farrukhzaf/spi-asic-configurator/docs/SPI_slave_design_report.pdf

# SPI Slave Register Interface

# Design Report

## From Initial Code Review to ASIC-Ready RTL

### Protocol: SPI Mode 0 (CPOL=0, CPHA=0) Frame: {R/W, A[6:0], D[7:0]} — 16 bits Registers: 5 × 8-bit programmable registers Target FPGA: Xilinx Basys 3 (Artix-7 XC7A35T) Target ASIC: Generic standard-cell library MCU: STM32G474 (SPI Master)

### March 28, 2026

SPI Slave Design Report | 1

## Contents

1 Introduction | 2
2 Design Specification | 2
3 Initial Code Review | 3
4 Revision 1: Functional Verification | 4
5 FPGA Prototyping on Basys 3 | 4
6 Difficulty 1: FPGA Race Condition on Memory Write | 5
7 Difficulty 2: ASIC Design Rule Violations | 6
8 Register Output Ports for Layout Integration | 7
9 Firmware Test Harness (STM32G474) | 8
10 Final Architecture Summary | 9
11 Design Revision History | 10
12 Conclusion | 10

## 1 Introduction

This report documents the complete design journey of an SPI slave register interface, from an initial buggy implementation through iterative debugging, FPGA validation, and final hardening for ASIC tape-out. The design went through five major revisions, each addressing a distinct class of issues discovered through simulation, hardware testing, or design-rule analysis.
The SPI slave provides a simple register-programming interface for an ASIC. An external SPI master (STM32G474 microcontroller) writes configuration data into five 8-bit registers, whose outputs are directly wired to downstream ASIC logic. The interface operates without a system clock—all sequential logic is clocked by the SPI clock (sclk) provided by the master.

## 2 Design Specification

### 2.1 Protocol Definition

Each SPI transaction consists of exactly 16 bits, clocked in SPI Mode 0 (CPOL=0, CPHA=0). The master holds chip select (cs) low for the duration of the 16-bit frame.

Table 1: 16-bit SPI frame format

Bit 15 | Bits [14:8] | Bits [7:0]
R/W | Address (A[6:0]) Data (D[7:0])
- R/W = 1: Write operation. The master sends data on MOSI during clocks 9–16, which is written to the addressed register.
- R/W = 0: Read operation. The slave drives the addressed register’s contents on MISO during clocks 9–16.
Both read and write complete in a single 16-bit transaction.

### 2.2 Register Map

Table 2: SPI register address map

Address | Register | Reset Value
0x00 | reg0 out | 0x00
0x01 | reg1 out | 0x00
0x02 | reg2 out | 0x00
0x03 | reg3 out | 0x00
0x04 | reg4 out | 0x00
0x05--0x7F | Reserved | Read returns 0xFF

### 2.3 SPI Mode 0 Timing

- sclk idles low between transactions.

- The master drives MOSI before the rising edge of sclk.
- The slave samples MOSI on the rising edge of sclk.
- The slave drives MISO on the falling edge of sclk, giving a full half-cycle of setup time before the master samples on the next rising edge.

## 3 Initial Code Review

The starting point was a Verilog module with five critical bugs. This section documents each issue and the rationale for the fix.

### 3.1 Bug 1: Inverted R/W Polarity

The specification defined the first bit as R/W bar: 1 = Read, 0 = Write. However, the original code treated rw bit == 1 as a write operation, reversing the intended behavior.

### 3.2 Bug 2: MISO Driven During the Wrong Phase

The original code used a condition miso cnt < 8 to drive MISO, which output data during the address phase (clocks 1–8). For a read operation, the slave must drive data during the data phase (clocks 9–16).

### 3.3 Bug 3: Late tx buffer Load

The tx buffer was loaded on posedge cs (the end of the transaction). For a sametransaction read, the data must be available before clock 9. The original design was effectively one full transaction late.
Solution — Predictive Load: At bit count == 7 on posedge sclk, the address is reconstructed from the current shift reg[5:0] (providing addr[6:1]) and the live mosi wire (providing addr[0]). This loads tx buffer at posedge 8, making it available by negedge 8 when MISO output begins.
1 | always @ ( posedge sclk or negedge rst_n ) begin
2 | if (! rst_n )
3 | tx_buffer <= 8 ’ h00 ;
4 | else if (! cs && bit_count == 5 ’ d7 && ! shift_reg [6]) begin
5 | if ({ shift_reg [5:0] , mosi } < MEM_DEPTH )
6 | tx_buffer <= reg_file [{ shift_reg [5:0] , mosi }];
7 | else
8 | tx_buffer <= 8 ’ hFF ;
9 | end
10 | end

Listing 1: Predictive tx buffer load

### 3.4 Bug 4: Combinational MISO Glitches

The original design used always @(*) to drive MISO, creating a combinational output path prone to glitches between clock edges. In Mode 0, MISO must be registered on negedge sclk to ensure stability when the master samples on the next rising edge.

### 3.5 Bug 5: Redundant Counters

Two separate counters (bit count and miso cnt) tracked the same transaction progress on different clock edges. A single bit count on posedge sclk suffices for both shift-in and shift-out logic.

## 4 Revision 1: Functional Verification

After fixing the five bugs identified in Section 3, a comprehensive testbench was written with seven test categories:

Table 3: Testbench coverage matrix

Test Category | Description
1 | Write all | Write distinct patterns to all 5 registers
2 | Read back | Read each register via MISO and compare
3 | Overwrite | Overwrite one register, verify others un-
touched
4 | Out-of-range RD | Read from invalid addresses (expect 0xFF)
5 | Out-of-range WR Write to invalid address, verify no corrup-
tion
6 | Zero value | Write and read 0x00 (distinguishable)
7 | Async reset | Assert rst n, verify all registers cleared

All 14 checks passed in Icarus Verilog simulation.

## 5 FPGA Prototyping on Basys 3

### 5.1 Top-Level Wrapper

A minimal top-level module mapped the SPI signals to PMOD JA pins on the Digilent Basys 3 board. The center push-button (BTNC) was used as an active-high reset, inverted internally to provide rst n.

Table 4: PMOD JA pin assignment

PMOD Pin Package Pin Signal | Direction
JA1 | J1 | sclk | Input
JA2 | L2 | mosi | Input
JA3 | J2 | cs | Input
JA4 | G2 | miso | Output
— | U18 | btnC | Input (reset)

### 5.2 XDC Constraints

A create clock constraint was applied to the SCLK input on PMOD JA with a 100 ns period (10 MHz). Configuration voltage was set to 3.3 V LVCMOS to match the PMOD

standard.

## 6 Difficulty 1: FPGA Race Condition on Memory Write

### 6.1 Symptom

The STM32 firmware test harness reported that all read-back values were incorrect after writing to multiple registers in sequence. Single-register write-then-read worked sporadically.

Table 5: Failing UART output (excerpt)

Test | Result

addr 0x00 got 0x00, expected 0xA5 — FAIL addr 0x02 got 0x0C, expected 0x0F — FAIL addr 0x03 got 0x01, expected 0x81 — FAIL

### 6.2 Root Cause Analysis

The memory write block triggered on posedge cs and sampled bit count == 16. However, the bit counter block also triggered on posedge cs, asynchronously resetting bit count to zero.
In simulation, Verilog’s non-blocking assignment semantics guarantee that both blocks see the old value of bit count at the same posedge cs. On real FPGA hardware, the asynchronous reset path through the clear pin of the bit count flip-flops is faster than the clocked data path to the memory-write logic. By the time the memory-write block’s flip-flops evaluate bit count, it has already been forced to zero.
This is a classic simulation-versus-hardware mismatch caused by racing asynchronous reset paths.

### 6.3 Fix: Move Memory Write to posedge sclk

The memory write was moved to fire on the 16th rising edge of sclk (detected as bit count == 15 pre-NBA). At this point, the frame is reconstructed from shift reg[14:0] and the live mosi wire:

1 | always @ ( posedge sclk or negedge rst_n ) begin
2 | if (! rst_n ) begin
3 | for ( i = 0; i < MEM_DEPTH ; i = i + 1)
4 | reg_file [ i ] <= 8 ’ h00 ;
5 | end else if (! cs && bit_count == 5 ’ d15 ) begin
6 | if ( shift_reg [14] && shift_reg [13:7] < MEM_DEPTH )
7 | reg_file [ shift_reg [13:7]] <= { shift_reg [6:0] , mosi };
8 | end
9 | end

Listing 2: Race-free memory write on posedge sclk

This completely eliminated the dependency on posedge cs for writes, removing the race condition. After this fix, all 17 firmware tests passed on hardware.

## 7 Difficulty 2: ASIC Design Rule Violations

While the FPGA-proven design was functionally correct, it contained several patterns that would cause failures during ASIC synthesis, STA, DFT, and physical design.

### 7.1 Issue 1: cs Used as Asynchronous Reset

In the FPGA version, posedge cs appeared in sensitivity lists for the bit counter, shift register, and MISO output. ASIC synthesis tools would route cs through a reset tree, but since cs transitions asynchronously relative to sclk, recovery and removal timing checks would fail. There is no deterministic timing relationship for STA tools to close on.

### 7.2 Issue 2: Multiple Clock Edges

posedge sclk and negedge sclk constitute two separate clock domains in ASIC timing analysis. Every signal crossing between them would be flagged as a clock-domain crossing (CDC) violation. Clock-tree synthesis (CTS) would need to build two independent clock trees from the same pin.

### 7.3 Issue 3: Scan Testability

DFT insertion requires controllable clocks and resets. With cs simultaneously acting as both a data input and an asynchronous reset, scan chains cannot properly shift through the affected flip-flops. The design would fail DFT rule checks.

### 7.4 Issue 4: Glitch Sensitivity

FPGA routing provides clean, glitch-free signal paths. On ASIC, any runt pulse or coupling-induced glitch on cs would corrupt bit count because it is wired as an asynchronous reset with no filtering.

### 7.5 The “Purely Synchronous” Dead End

The first attempted fix was to make the design fully synchronous: sample cs on posedge sclk using a delayed copy (cs d) for edge detection, and use an active flag to track frame boundaries.
This approach failed fundamentally because in SPI Mode 0, sclk idles low between transactions. With no clock edges between frames, the synchronous logic never observes cs going high and then low again. The bit count remained stuck at 16 from the previous transaction, and all subsequent transactions failed.

### 7.6 The Correct ASIC Solution

The solution applies cs as an asynchronous clear to bit count only—not as a generalpurpose clock or reset for all logic:

1 | always @ ( posedge sclk or posedge cs or negedge rst_n ) begin
2 | if (! rst_n )
3 | bit_count <= 5 ’ b0 ;
4 | else if ( cs )
5 | bit_count <= 5 ’ b0 ;
6 | else if ( bit_count < 5 ’ d16 )
7 | bit_count <= bit_count + 1 ’ b1 ;
8 | end

Listing 3: Targeted async clear on bit count

This is safe because the SPI protocol guarantees that cs transitions only while sclk is idle (low in Mode 0). There is no simultaneous clock edge to race against, so recovery/removal timing is inherently satisfied.
All other blocks sample cs as a synchronous data input via posedge sclk, and only rst n serves as the global asynchronous reset.

Table 6: FPGA vs. ASIC design comparison

Concern | FPGA Version | ASIC Version
cs as clock | posedge cs triggers memory writes Never
Clock domains | 3 (posedge, negedge, posedge cs) | 2 (posedge + 1 negedge flop)
cs as async reset Resets bit count, shift reg, miso | Clears bit count only
DFT / Scan | Not testable | Clean
Memory write | On posedge cs (race) | On posedge sclk

### 7.7 SDC Constraints for ASIC

The following Synopsys Design Constraints are required:

1 | # Primary SPI clock
2 | create_clock -name sclk -period <T > [ get_ports sclk ]

3
4 | # Inverted clock for the single MISO output flop
5 | create_generated_clock -name sclk_inv \
6 | -source [ get_ports sclk ] \
7 | -divide_by 1 -invert \
8 | [ get_pins miso_reg / CK ]

9
10 | # cs-to-bit_count async clear is safe (SPI protocol guarantee )
11 | set_false_path -from [ get_ports cs ] \
12 | -to [ get_pins bit_count_reg* / CLR ]

Listing 4: SDC constraints for the SPI slave

## 8 Register Output Ports for Layout Integration

The final revision replaced the internal memory array with named registers (reg file) and exposed their contents as output ports. This change was necessary for two reasons:

1. Functional: Without output ports, downstream ASIC logic cannot access the register values.
2. Physical design: Synthesis tools may infer the reg [7:0] memory [0:4] array as a small RAM or generate awkwardly named nets (memory reg 0 , etc.) that are difficult to trace in layout and LVS. Named output ports produce clean, predictable pin names in LEF/DEF.
1 | output wire [7:0] reg0_out , | // addr 0x00
2 | output wire [7:0] reg1_out , | // addr 0x01
3 | output wire [7:0] reg2_out , | // addr 0x02
4 | output wire [7:0] reg3_out , | // addr 0x03
5 | output wire [7:0] reg4_out | // addr 0x04

6
7 | // ...
8 | assign reg0_out = reg_file [0];
9 | assign reg1_out = reg_file [1];
10 | assign reg2_out = reg_file [2];
11 | assign reg3_out = reg_file [3];
12 | assign reg4_out = reg_file [4];

Listing 5: Register output port declarations

The outputs are purely combinational (assign from register flip-flops)—zero additional logic. They update on the 16th SCLK rising edge of a write transaction, hold their value indefinitely until the next write or reset, and go to 0x00 on rst n assertion.

## 9 Firmware Test Harness (STM32G474)

An STM32G474 microcontroller served as the SPI master for hardware validation. The firmware test harness on the STM32 mirrored all seven simulation test categories plus hardware-specific checks.

### 9.1 Test Architecture

The firmware used three helper functions:
- asic write(addr, val) — SPI write with error checking.
- asic read(addr, &val) — SPI read with error checking.
- check(addr, expected) — Read-and-compare with [PASS]/[FAIL] logging via UART at 115200 baud.
Hardware reset (Test 7) was implemented using a dedicated GPIO pin driving the ASIC’s rst n input, with 2 ms assert/deassert delays.

### 9.2 Final Hardware Results

Table 7: Final FPGA hardware test results

Test Category | Result
1 | Write all 5 registers | PASS (5/5)
2 | Read back all 5 registers | PASS (5/5)
3 | Overwrite addr 0, verify others | PASS (2/2)
4 | Read out-of-range addresses | PASS (2/2)
5 | Write out-of-range, no corruption | PASS (2/2)
6 | Write and read 0x00 | PASS (1/1)
7 | Hardware reset clears all registers | PASS (5/5)
Total | 17/17 PASSED

## 10 Final Architecture Summary

The final RTL consists of five cleanly separated always blocks:

Table 8: Final RTL block summary

Block Function | Clock Edge | Async | Domain
1 | Bit counter | posedge sclk | rst n, cs | sclk
2 | Shift register | posedge sclk | rst n | sclk
3 | TX buffer load posedge sclk | rst n | sclk
4 | MISO output | negedge sclk | rst n | sclk inv
5 | Memory write | posedge sclk | rst n | sclk

Key properties of the final design:
- Single clock source: All logic derives from sclk. Only the MISO output flop uses the inverted edge, constrained as a generated clock (sclk inv).
- Single global async reset: Only rst n resets all flip-flops.
- Targeted async clear: cs clears only bit count, with protocol-guaranteed safety.
- No combinational outputs: MISO is fully registered.
- No system clock dependency: The entire design operates solely from the SPI master’s clock.
- DFT-ready: One scan-mode mux on the negedge MISO flop.
- Clean output ports: Five named 8-bit outputs for direct connection to downstream ASIC logic.

## 11 Design Revision History

Table 9: Design revision timeline

Rev Milestone | Key Changes
0 | Initial code | Original submission with 5 bugs
1 | Simulation pass | Fixed R/W polarity, MISO timing, pre-
dictive tx buffer, registered MISO, single counter
2 | Signal rename | Changed cs n → cs; | R/W: 1=Write,
| | 0=Read
3 | FPGA race fix | Moved memory write from posedge cs to
| | posedge sclk
4 | ASIC hardening Removed cs as clock/reset except targeted
bit count clear; SDC constraints added
5 | Output ports | Replaced memory array with reg file;
added reg[0..4] out ports

## 12 Conclusion

This design evolved through five revisions, each driven by a specific failure mode. The initial code review caught fundamental protocol bugs visible in simulation. FPGA testing revealed a hardware race condition invisible to simulation. ASIC design-rule analysis exposed structural issues that would have caused synthesis, timing, and DFT failures. The final RTL is simultaneously functional on FPGA (validated with 17/17 hardware tests) and compliant with ASIC design rules. It requires no system clock, uses a single SPI clock source with one inverted output flop, and exposes clean register output ports for physical design integration.
The key lesson reinforced by this project is that passing simulation is necessary but not sufficient. Each target platform—behavioral simulation, FPGA, and ASIC—imposes additional constraints that can only be satisfied through targeted analysis and testing at each level.
